CollinsSam10/Body-Mass-Indicator/README.md

# Body-Mass-Indicator
This project basically measures the height and weight of a patient/user using an ultrasonic sensor and load cell respectively. The obtained values is used to compute the body mass index of the patient/user.  The height, weight and body mass index of the patient is displayed afterward together with a recommendation corresponding with the BMI level, on a 16*2 LCD.
